anton-jh/Side-panels/Side panel left.dxf

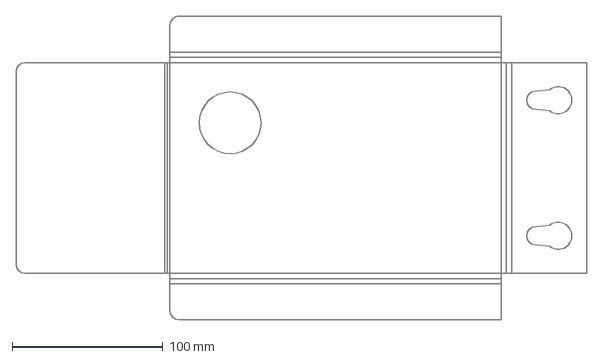
[picture p1: CAD file, 2025-12-23]
Side panel left.dxf
378.9 x 201.6 mm
