anton-jh/Side-panels/Adapter bracket primary.dxf

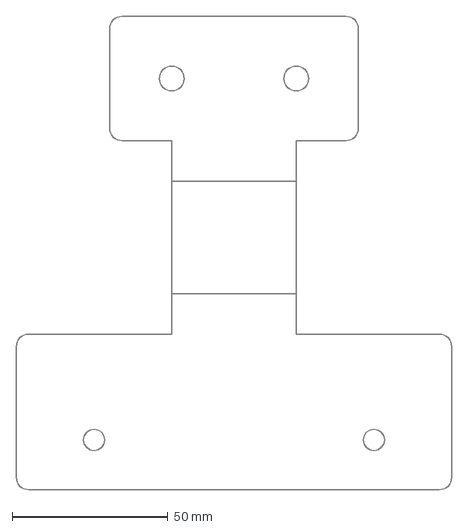
[picture p2: CAD file, 2025-12-23]
Adapter bracket primary.dxf
140.0 x 152.2 mm
