anton-jh/Side-panels/Chair mount adapter.dxf

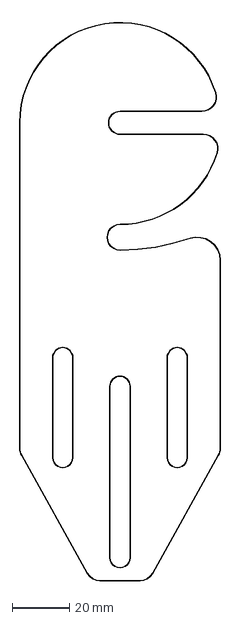
[picture p3: CAD file, 2025-12-23]
Chair mount adapter.dxf
70.0 x 197.2 mm
