anton-jh/Side-panels/Adapter bracket secondary left.dxf

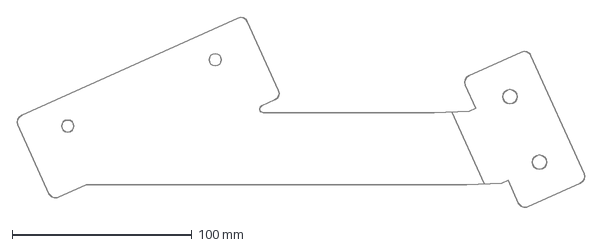
[picture p4: CAD file, 2025-12-23]
Adapter bracket secondary left.dxf
316.8 x 106.4 mm
