anton-jh/Side-panels/PCBs/Shift_Register_Module/Shift_Register_Module.kicad_pcb

## KiCad design PCBs/Shift_Register_Module/Shift_Register_Module.kicad_pcb (2026-11-09)

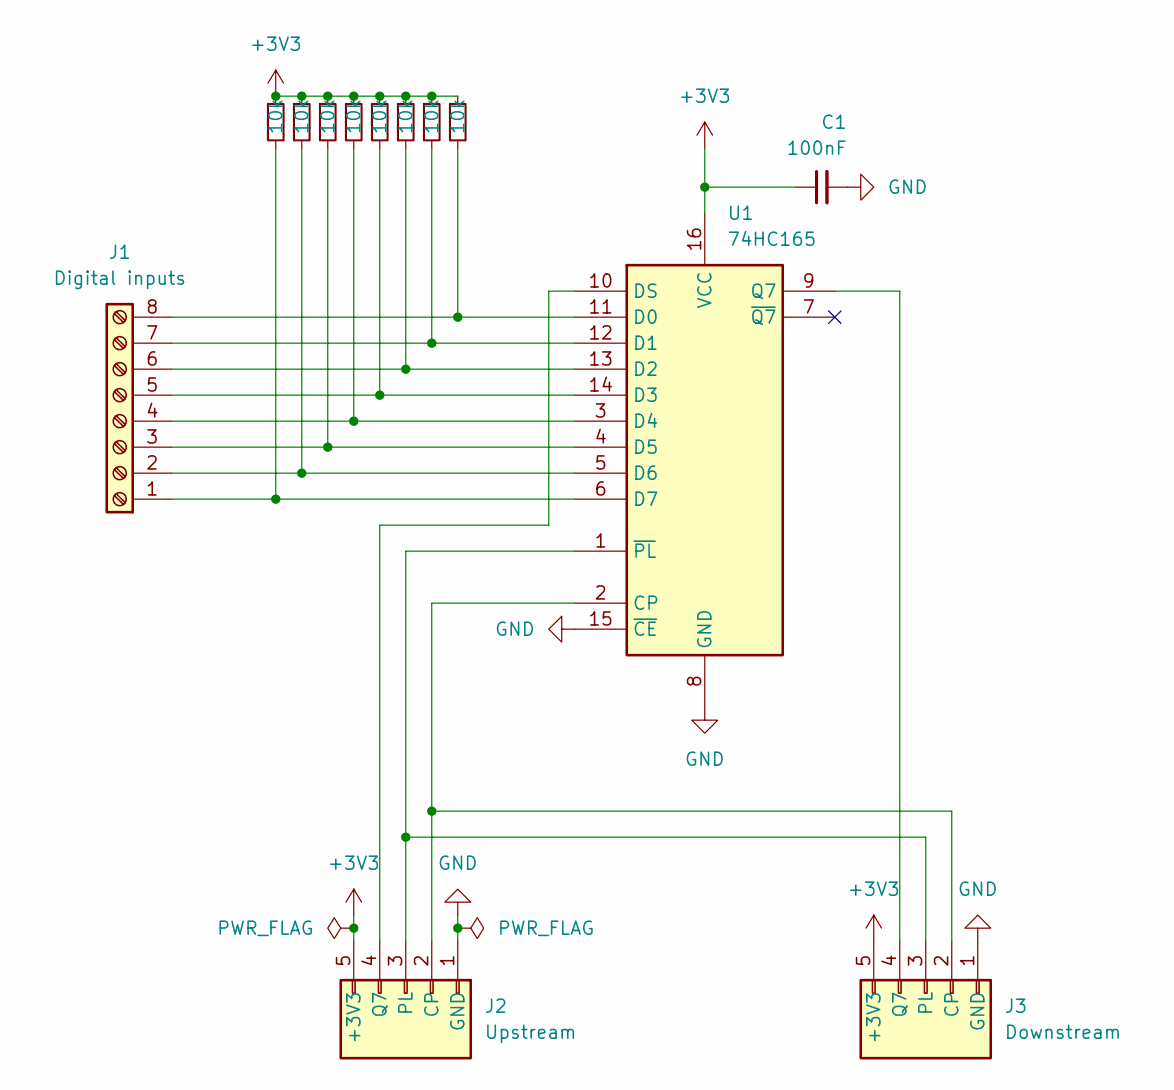
[picture p5: schematic Shift_Register_Module.kicad_sch]

Parts:
C1: 100nF; C_Disc_D5.0mm_W2.5mm_P2.50mm
J1: Digital inputs; TerminalBlock_Phoenix_MPT-0,5-8-2.54_1x08_P2.54mm_Horizontal
J2: Upstream; PinSocket_1x05_P2.54mm_Horizontal
J3: Downstream; PinHeader_1x05_P2.54mm_Horizontal
R1, R2, R3, R4, R5, R6, R7, R8: 10k; R_Axial_DIN0204_L3.6mm_D1.6mm_P1.90mm_Vertical
U1: 74HC165; DIP-16_W7.62mm_Socket

Connections:
+3V3: C1.1, J2.5 (+3V3), J3.5 (+3V3), R1.1, R2.1, R3.1, R4.1, R5.1, R6.1, R7.1, R8.1, U1.16 (VCC)
GND: C1.2, J2.1 (GND), J3.1 (GND), U1.8 (GND), U1.15 (~CE)
unnamed: J1.1, R1.2, U1.6 (D7)
unnamed: J1.2, R2.2, U1.5 (D6)
unnamed: J1.3, R3.2, U1.4 (D5)
unnamed: J1.4, R4.2, U1.3 (D4)
unnamed: J1.5, R5.2, U1.14 (D3)
unnamed: J1.6, R6.2, U1.13 (D2)
unnamed: J1.7, R7.2, U1.12 (D1)
unnamed: J1.8, R8.2, U1.11 (D0)
unnamed: J2.2 (CP), J3.2 (CP), U1.2 (CP)
unnamed: J2.4 (SER), U1.10 (DS)
unnamed: J2.3 (/PL), J3.3 (/PL), U1.1 (~PL)
unnamed: J3.4 (SER), U1.9 (Q7)

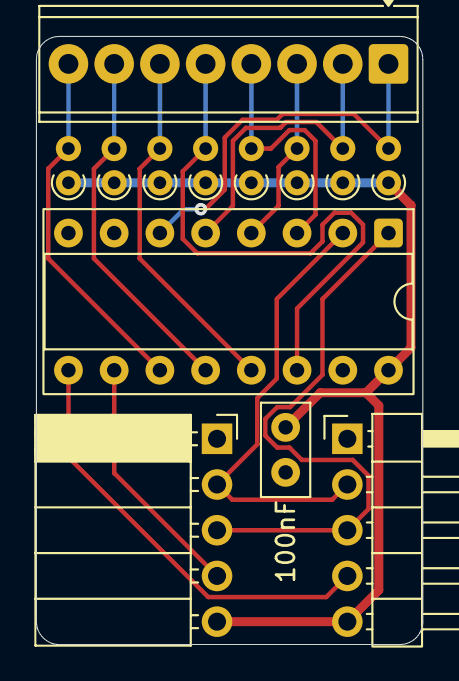
[picture p6: board Shift_Register_Module.kicad_pcb from above]

Board: 2 copper layers, 21.5 x 33.8 mm, 13 parts (0 on the bottom side), 14 nets.
