anton-jh/Side-panels/PCBs/Shared_Main/Shared_Main.kicad_pcb

## KiCad design PCBs/Shared_Main/Shared_Main.kicad_pcb (2026-11-09)

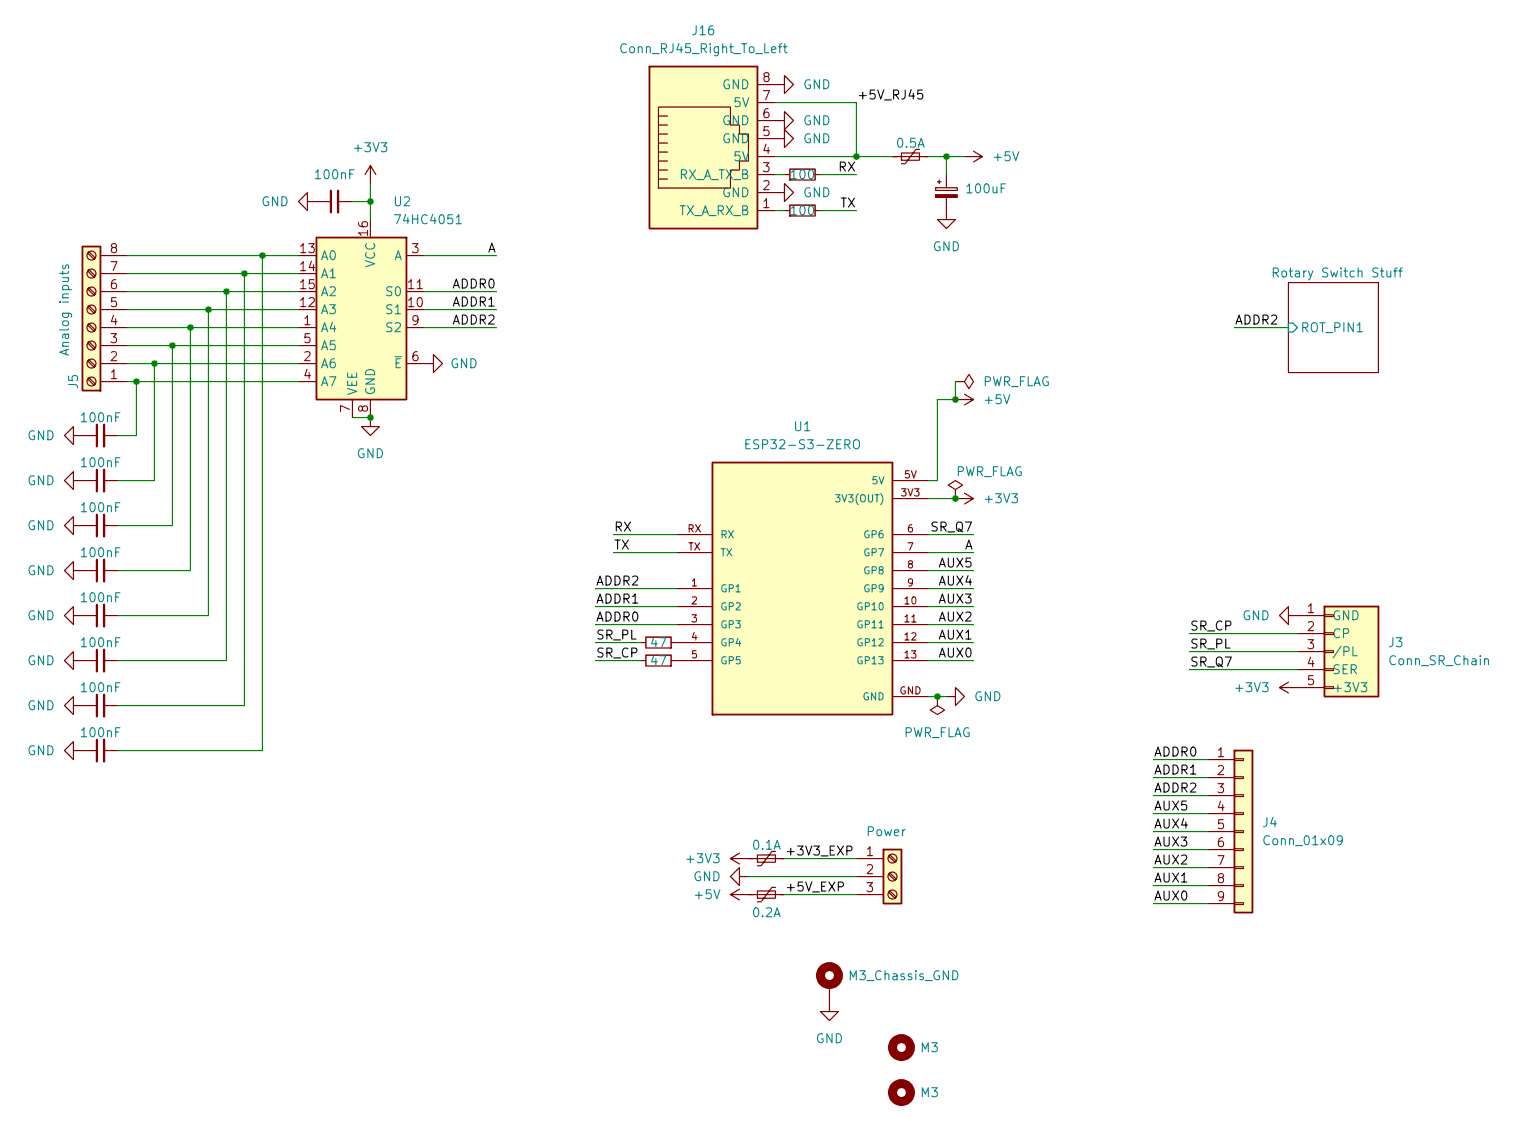
[picture p7: schematic Shared_Main.kicad_sch]

Parts:
C1, C12, C13, C14, C15, C16, C17, C18, C19: 100nF; C_Disc_D5.0mm_W2.5mm_P2.50mm
C3: 100uF; CP_Radial_D5.0mm_P2.00mm
F1: 0.5A; Fuse_Bourns_MF-RHT050
F2: 0.1A; Fuse_Bourns_MF-RHT050
F3: 0.2A; Fuse_Bourns_MF-RHT050
H1: M3_Chassis_GND; MountingHole_3.2mm_M3_DIN965_Pad_TopOnly
H2, H3: M3; MountingHole_3.2mm_M3
J1: Power; TerminalBlock_Phoenix_MKDS-1,5-3_1x03_P5.00mm_Horizontal
J3: Conn_SR_Chain; PinSocket_1x05_P2.54mm_Horizontal
J4: Conn_01x09; PinHeader_1x09_P2.54mm_Vertical
J5: Analog inputs; TerminalBlock_Phoenix_MPT-0,5-8-2.54_1x08_P2.54mm_Horizontal
J16: Conn_RJ45_Right_To_Left; RJ45_Amphenol_54602-x08_Horizontal
R2, R3: 100; R_Axial_DIN0207_L6.3mm_D2.5mm_P7.62mm_Horizontal
R9, R10: 47; R_Axial_DIN0207_L6.3mm_D2.5mm_P7.62mm_Horizontal
U1: ESP32-S3-ZERO; MODULE_ESP32-S3-ZERO; PARTREV NA
U2: 74HC4051; DIP-16_W7.62mm_Socket

Connections:
+3V3: C1.2, F2.1, J3.5 (+3V3), U1.3V3 (3V3(OUT)), U2.16 (VCC)
+5V: C3.1, F1.2, F3.1, U1.5V
/+3V3_EXP: F2.2, J1.1
/+5V_EXP: F3.2, J1.3
/+5V_RJ45: F1.1, J16.4 (5V), J16.7 (5V)
/A: U1.7 (GP7), U2.3 (A)
/ADDR0: J4.1, U1.3 (GP3), U2.11 (S0)
/ADDR1: J4.2, U1.2 (GP2), U2.10 (S1)
/ADDR2: J4.3, U1.1 (GP1), U2.9 (S2); also elsewhere on the board
/AUX0: J4.9, U1.13 (GP13)
/AUX1: J4.8, U1.12 (GP12)
/AUX2: J4.7, U1.11 (GP11)
/AUX3: J4.6, U1.10 (GP10)
/AUX4: J4.5, U1.9 (GP9)
/AUX5: J4.4, U1.8 (GP8)
/RX: R2.2, U1.RX
/SR_CP: J3.2 (CP), R10.2
/SR_PL: J3.3 (/PL), R9.2
/SR_Q7: J3.4 (SER), U1.6 (GP6)
/TX: R3.2, U1.TX
GND: C1.1, C3.2, C12.1, C13.1, C14.1, C15.1, C16.1, C17.1, C18.1, C19.1, H1.1 (1_1), J1.2, J3.1 (GND), J16.2 (GND), J16.5 (GND), J16.6 (GND), J16.8 (GND), U1.GND, U2.6 (~E), U2.7 (VEE), U2.8 (GND); also elsewhere on the board
unnamed: C12.2, J5.1, U2.4 (A7)
unnamed: C13.2, J5.2, U2.2 (A6)
unnamed: C14.2, J5.3, U2.5 (A5)
unnamed: C15.2, J5.4, U2.1 (A4)
unnamed: C16.2, J5.5, U2.12 (A3)
unnamed: C17.2, J5.6, U2.15 (A2)
unnamed: C18.2, J5.7, U2.14 (A1)
unnamed: C19.2, J5.8, U2.13 (A0)
unnamed: J16.3 (RX_A_TX_B), R2.1
unnamed: J16.1 (TX_A_RX_B), R3.1
unnamed: R9.1, U1.4 (GP4)
unnamed: R10.1, U1.5 (GP5)

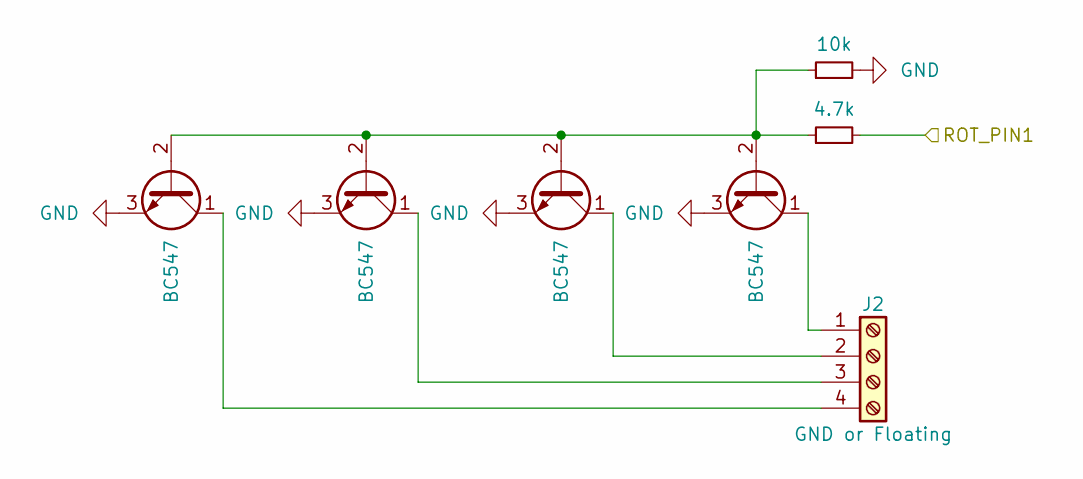
[picture p8: schematic Rotary_Switch_Stuff.kicad_sch]

Parts:
J2: GND or Floating; TerminalBlock_Phoenix_MPT-0,5-4-2.54_1x04_P2.54mm_Horizontal
Q1, Q2, Q3, Q4: BC547; TO-92_Inline_Wide
R1: 4.7k; R_Axial_DIN0207_L6.3mm_D2.5mm_P7.62mm_Horizontal
R7: 10k; R_Axial_DIN0207_L6.3mm_D2.5mm_P7.62mm_Horizontal

Connections:
/ADDR2: R1.2; also elsewhere on the board
GND: Q1.3 (E), Q2.3 (E), Q3.3 (E), Q4.3 (E), R7.2; also elsewhere on the board
unnamed: J2.1, Q4.1 (C)
unnamed: J2.2, Q3.1 (C)
unnamed: J2.3, Q2.1 (C)
unnamed: J2.4, Q1.1 (C)
unnamed: Q1.2 (B), Q2.2 (B), Q3.2 (B), Q4.2 (B), R1.1, R7.1

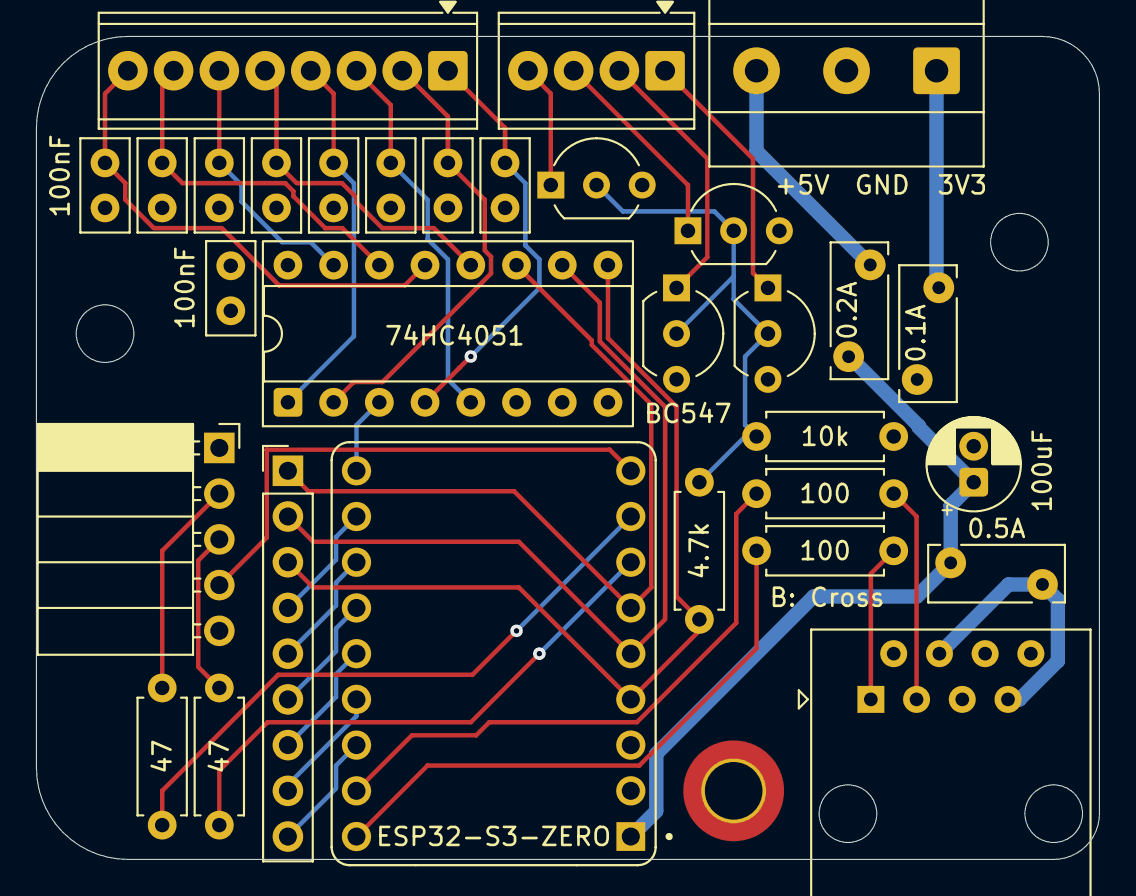
[picture p9: board Shared_Main.kicad_pcb from above]

Board: 4 copper layers, 59.1 x 45.7 mm, 34 parts (0 on the bottom side), 38 nets.
