anton-jh/Side-panels/PCBs/Right_Keypad/Right_Keypad.kicad_pcb

## KiCad design PCBs/Right_Keypad/Right_Keypad.kicad_pcb (2026-11-03)

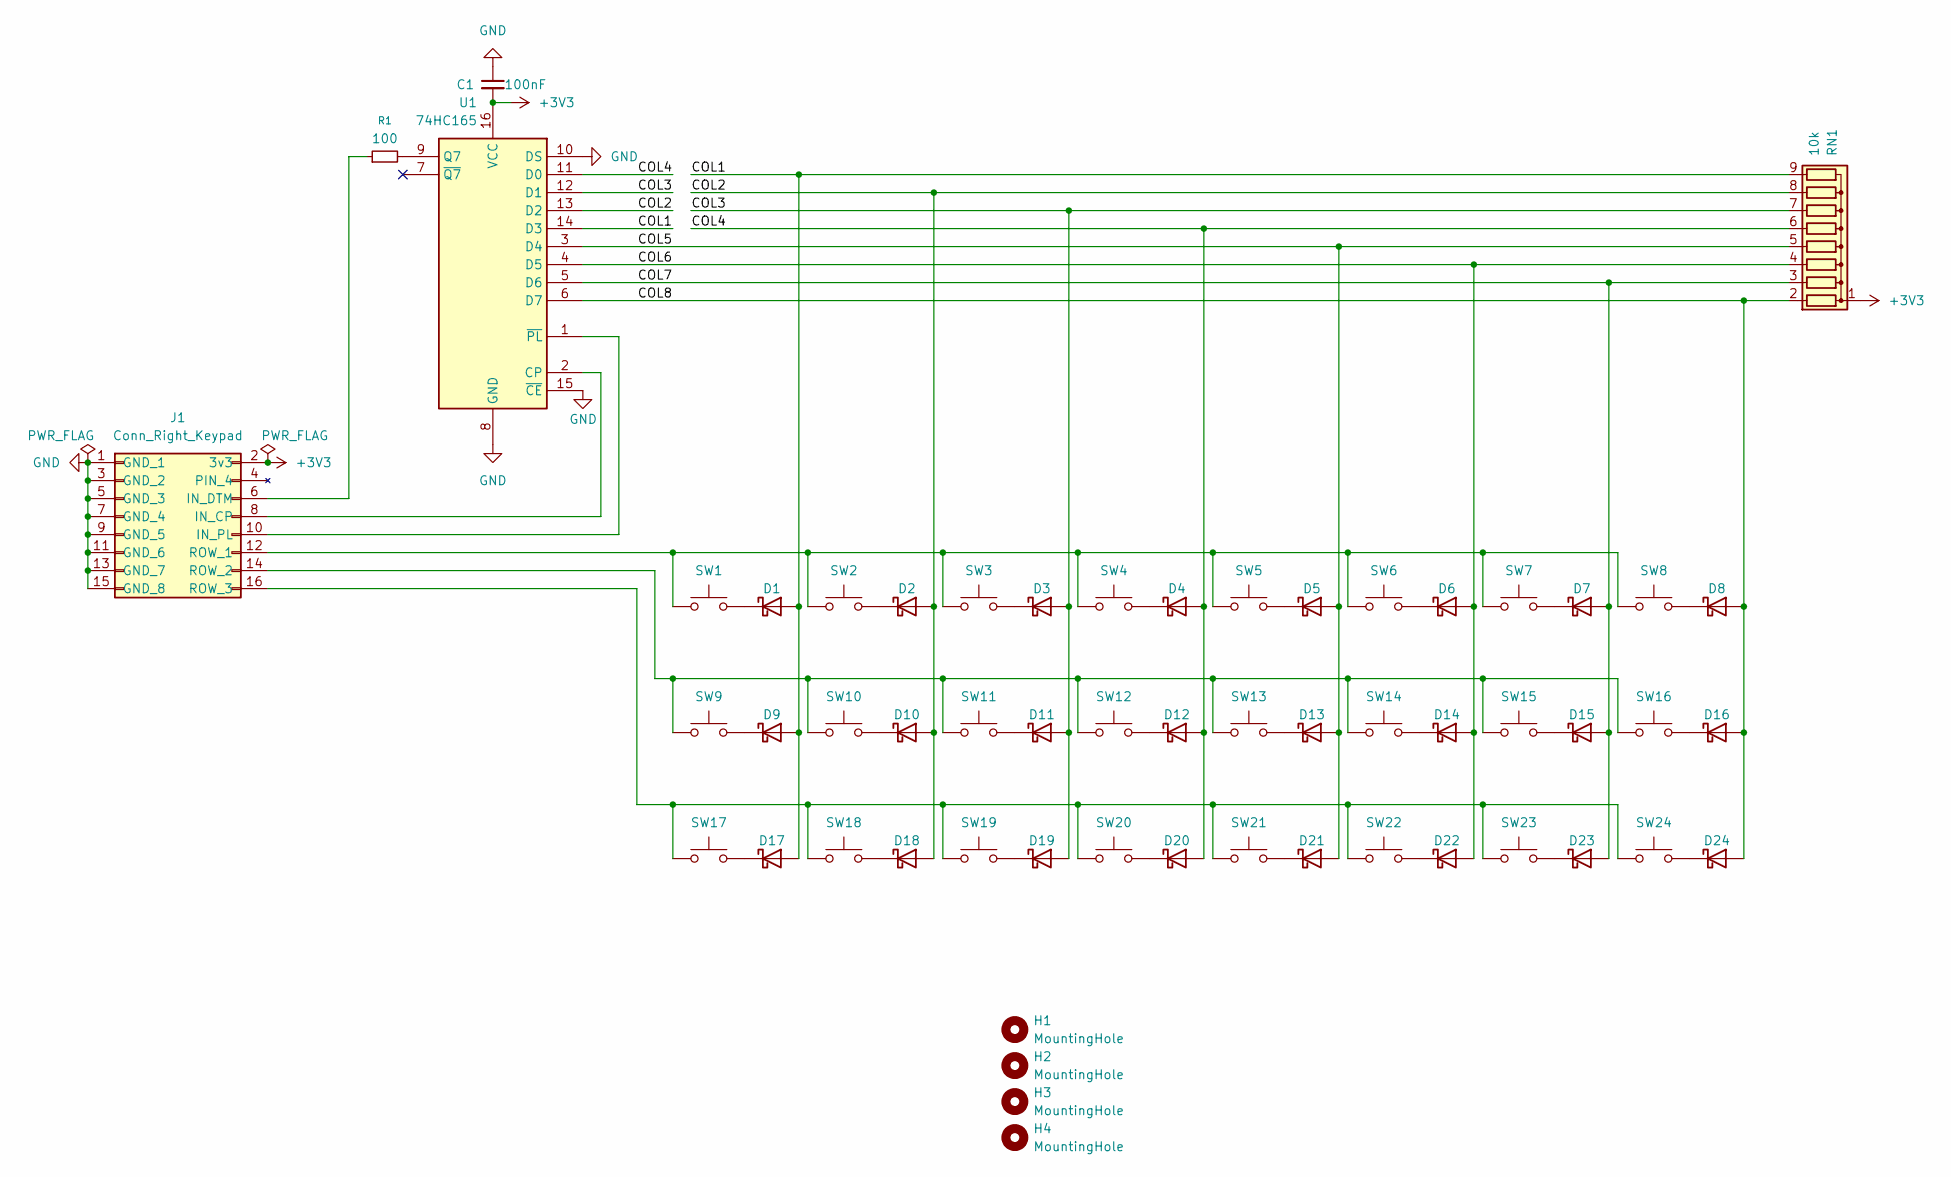
[picture p10: schematic Right_Keypad.kicad_sch]

Parts:
C1: 100nF; C_Disc_D5.0mm_W2.5mm_P2.50mm
D1, D2, D3, D4, D5, D6, D7, D8, D9, D10, D11, D12, D13, D14, D15, D16, D17, D18, D19, D20, D21, D22, D23, D24: SD103AWS; D_SOD-323_HandSoldering
H1, H2, H3, H4: MountingHole; MountingHole_3.2mm_M3
J1: Conn_Right_Keypad; IDC-Header_2x08_P2.54mm_Vertical
R1: 100; R_Axial_DIN0207_L6.3mm_D2.5mm_P7.62mm_Horizontal
RN1: 10k; R_Array_SIP9
SW1, SW2, SW3, SW4, SW5, SW6, SW7, SW8, SW9, SW10, SW11, SW12, SW13, SW14, SW15, SW16, SW17, SW18, SW19, SW20, SW21, SW22, SW23, SW24: SW_Push; SW_PUSH-12mm_Grid
U1: 74HC165; DIP-16_W7.62mm

Connections:
+3V3: C1.2, J1.2 (3v3), RN1.1 (common), U1.16 (VCC)
/COL1: D1.2 (A), D9.2 (A), D17.2 (A), RN1.9 (R8), U1.14 (D3)
/COL2: D2.2 (A), D10.2 (A), D18.2 (A), RN1.8 (R7), U1.13 (D2)
/COL3: D3.2 (A), D11.2 (A), D19.2 (A), RN1.7 (R6), U1.12 (D1)
/COL4: D4.2 (A), D12.2 (A), D20.2 (A), RN1.6 (R5), U1.11 (D0)
/COL5: D5.2 (A), D13.2 (A), D21.2 (A), RN1.5 (R4), U1.3 (D4)
/COL6: D6.2 (A), D14.2 (A), D22.2 (A), RN1.4 (R3), U1.4 (D5)
/COL7: D7.2 (A), D15.2 (A), D23.2 (A), RN1.3 (R2), U1.5 (D6)
/COL8: D8.2 (A), D16.2 (A), D24.2 (A), RN1.2 (R1), U1.6 (D7)
GND: C1.1, J1.1 (GND_1), J1.3 (GND_2), J1.5 (GND_3), J1.7 (GND_4), J1.9 (GND_5), J1.11 (GND_6), J1.13 (GND_7), J1.15 (GND_8), U1.8 (GND), U1.10 (DS), U1.15 (~CE)
unnamed: D1.1 (K), SW1.2
unnamed: D2.1 (K), SW2.2
unnamed: D3.1 (K), SW3.2
unnamed: D4.1 (K), SW4.2
unnamed: D5.1 (K), SW5.2
unnamed: D6.1 (K), SW6.2
unnamed: D7.1 (K), SW7.2
unnamed: D8.1 (K), SW8.2
unnamed: D9.1 (K), SW9.2
unnamed: D10.1 (K), SW10.2
unnamed: D11.1 (K), SW11.2
unnamed: D12.1 (K), SW12.2
unnamed: D13.1 (K), SW13.2
unnamed: D14.1 (K), SW14.2
unnamed: D15.1 (K), SW15.2
unnamed: D16.1 (K), SW16.2
unnamed: D17.1 (K), SW17.2
unnamed: D18.1 (K), SW18.2
unnamed: D19.1 (K), SW19.2
unnamed: D20.1 (K), SW20.2
unnamed: D21.1 (K), SW21.2
unnamed: D22.1 (K), SW22.2
unnamed: D23.1 (K), SW23.2
unnamed: D24.1 (K), SW24.2
unnamed: J1.8 (IN_CP), U1.2 (CP)
unnamed: J1.6 (IN_DTM), R1.1
unnamed: J1.10 (IN_PL), U1.1 (~PL)
unnamed: J1.12 (ROW_1), SW1.1, SW2.1, SW3.1, SW4.1, SW5.1, SW6.1, SW7.1, SW8.1
unnamed: J1.14 (ROW_2), SW9.1, SW10.1, SW11.1, SW12.1, SW13.1, SW14.1, SW15.1, SW16.1
unnamed: J1.16 (ROW_3), SW17.1, SW18.1, SW19.1, SW20.1, SW21.1, SW22.1, SW23.1, SW24.1
unnamed: R1.2, U1.9 (Q7)

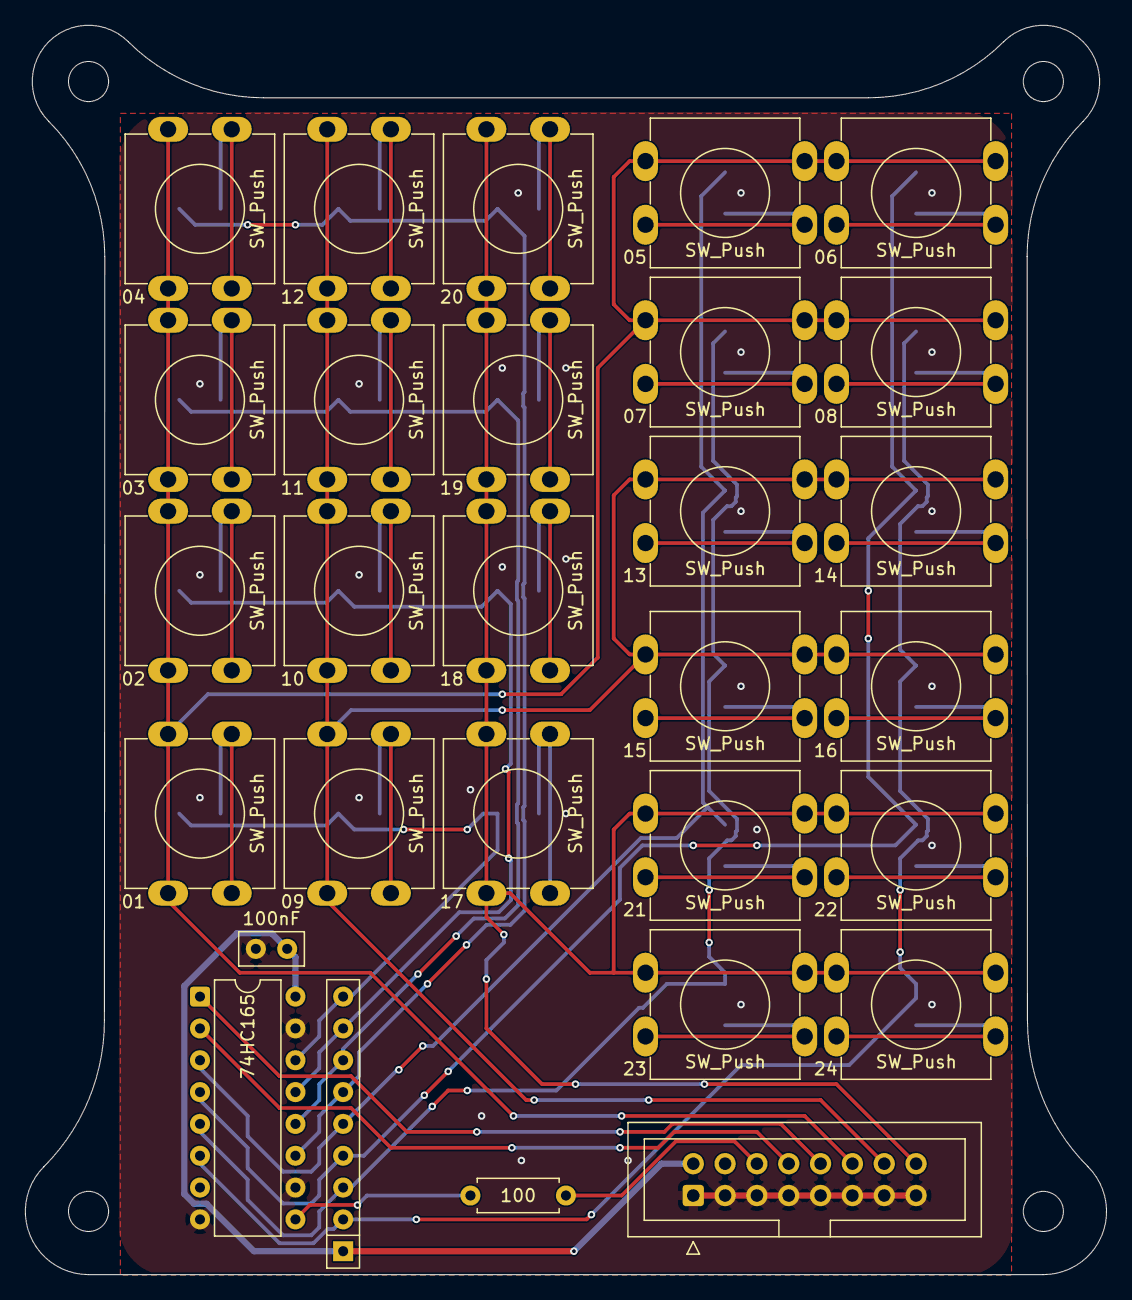
[picture p11: board Right_Keypad.kicad_pcb from above]

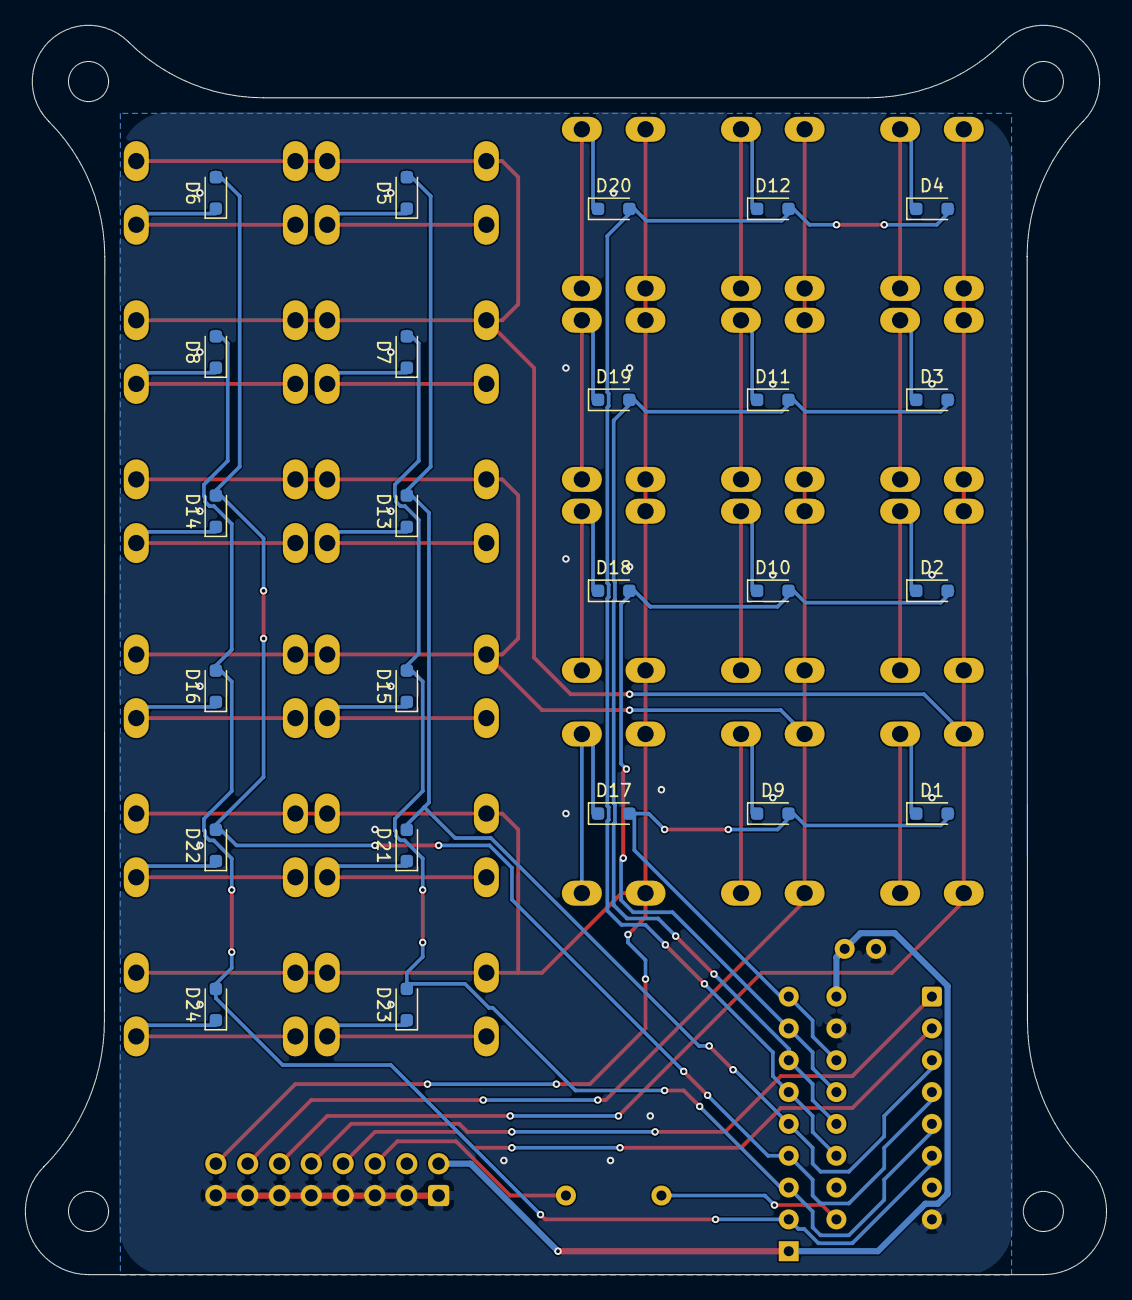
[picture p12: board Right_Keypad.kicad_pcb from below]

Board: 2 copper layers, 86.3 x 99.7 mm, 57 parts (24 on the bottom side), 41 nets.
