anton-jh/Side-panels/PCBs/Right_Main/Right_Main.kicad_pcb

## KiCad design PCBs/Right_Main/Right_Main.kicad_pcb (2026-07-09)

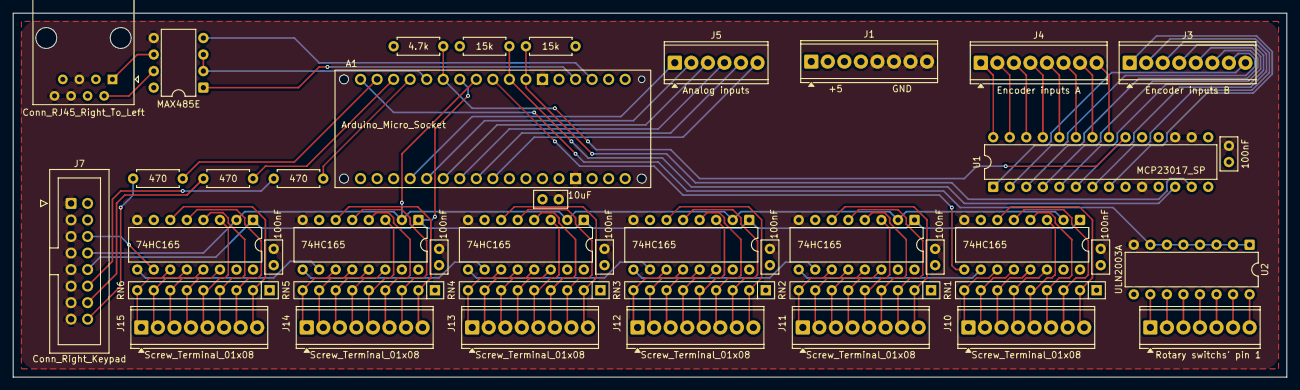
[picture p13: board Right_Main.kicad_pcb from above]

Board: 4 copper layers, 195.6 x 55.9 mm, 43 parts (0 on the bottom side), 103 nets.

Parts:
A1: Arduino_Micro_Socket
C1, C4, C5, C6, C7, C8, C9: 100nF; C_Disc_D5.0mm_W2.5mm_P2.50mm
C2: 10uF; C_Disc_D5.0mm_W2.5mm_P2.50mm
J1: +5V and GND; TerminalBlock_Phoenix_MPT-0,5-8-2.54_1x08_P2.54mm_Horizontal
J3: Encoder inputs B; TerminalBlock_Phoenix_MPT-0,5-8-2.54_1x08_P2.54mm_Horizontal
J4: Encoder inputs A; TerminalBlock_Phoenix_MPT-0,5-8-2.54_1x08_P2.54mm_Horizontal
J5: Analog inputs; TerminalBlock_Phoenix_MPT-0,5-6-2.54_1x06_P2.54mm_Horizontal
J7: Conn_Right_Keypad; IDC-Header_2x08_P2.54mm_Vertical
J8: Rotary switchs' pin 1; TerminalBlock_Phoenix_MPT-0,5-7-2.54_1x07_P2.54mm_Horizontal
J10, J11, J12, J13, J14, J15: Screw_Terminal_01x08; TerminalBlock_Phoenix_MPT-0,5-8-2.54_1x08_P2.54mm_Horizontal
J16: Conn_RJ45_Right_To_Left; RJ45_Amphenol_54602-x08_Horizontal
R1, R2: 15k; R_Axial_DIN0207_L6.3mm_D2.5mm_P7.62mm_Horizontal
R3: 4.7k; R_Axial_DIN0207_L6.3mm_D2.5mm_P7.62mm_Horizontal
R4, R5, R6: 470; R_Axial_DIN0207_L6.3mm_D2.5mm_P7.62mm_Horizontal
RN1, RN2, RN3, RN4, RN5, RN6: R_Network08; R_Array_SIP9
U1: MCP23017_SP; DIP-28_W7.62mm
U2: ULN2003A; DIP-16_W7.62mm
U4, U5, U6, U7, U8, U9: 74HC165; DIP-16_W7.62mm
U10: MAX485E; DIP-8_W7.62mm

Connections:
+5V: A1.5V, C1.1, C2.2, C4.2, C5.2, C6.2, C7.2, C8.2, C9.2, J1.1, J1.2, J1.3, J1.4, J7.2 (5V), J16.3 (+), J16.4 (+), J16.7 (+), R1.2, R2.2, R3.1, RN1.1 (common), RN2.1 (common), RN3.1 (common), RN4.1 (common), RN5.1 (common), RN6.1 (common), U1.9 (VDD), U1.15 (A0), U1.18 (~RESET), U4.16 (VCC), U5.16 (VCC), U6.16 (VCC), U7.16 (VCC), U8.16 (VCC), U9.16 (VCC), U10.8 (VCC)
/Input register 1/CP: A1.D5, J7.8 (IN_CP), U4.2 (CP), U5.2 (CP), U6.2 (CP), U7.2 (CP), U8.2 (CP), U9.2 (CP)
/Input register 1/DS: U4.10 (DS), U5.9 (Q7)
/Input register 1/Q7: A1.D4, U4.9 (Q7)
/Input register 1//PL: A1.D6, J7.10 (IN_PL), U4.1 (~PL), U5.1 (~PL), U6.1 (~PL), U7.1 (~PL), U8.1 (~PL), U9.1 (~PL)
/Input register 2/DS: U5.10 (DS), U6.9 (Q7)
/Input register 3/DS: U6.10 (DS), U7.9 (Q7)
/Input register 4/DS: U7.10 (DS), U8.9 (Q7)
/Input register 5/DS: U8.10 (DS), U9.9 (Q7)
/Input register 6/DS: J7.6 (IN_DTM), U9.10 (DS)
GND: A1.GND1 (GND), A1.GND2 (GND), C1.2, C2.1, C4.1, C5.1, C6.1, C7.1, C8.1, C9.1, J1.5, J1.6, J1.7, J1.8, J7.1 (GND_1), J7.3 (GND_2), J7.5 (GND_3), J7.7 (GND_4), J7.9 (GND_5), J7.11 (GND_6), J7.13 (GND_7), J7.15 (GND_8), J16.5 (-), J16.6 (-), J16.8 (-), U1.10 (VSS), U1.16 (A1), U1.17 (A2), U2.8 (GND), U4.8 (GND), U4.15 (~CE), U5.8 (GND), U5.15 (~CE), U6.8 (GND), U6.15 (~CE), U7.8 (GND), U7.15 (~CE), U8.8 (GND), U8.15 (~CE), U9.8 (GND), U9.15 (~CE), U10.5 (GND)
unnamed: A1.D0 (D0/RX), U10.1 (RO)
unnamed: A1.D1 (D1/TX), U10.4 (DI)
unnamed: A1.D2 (D2/SDA), R2.1, U1.13 (SDA)
unnamed: A1.D3 (D3/SCL), R1.1, U1.12 (SCK)
unnamed: A1.D7 (D7_INT4), R3.2, U1.20 (INTA)
unnamed: A1.D9, R4.1
unnamed: A1.D10, R5.1
unnamed: A1.D11, R6.1
unnamed: J3.8, U1.1 (GPB0)
unnamed: J3.7, U1.2 (GPB1)
unnamed: J3.6, U1.3 (GPB2)
unnamed: J3.5, U1.4 (GPB3)
unnamed: J3.4, U1.5 (GPB4)
unnamed: J3.3, U1.6 (GPB5)
unnamed: J3.2, U1.7 (GPB6)
unnamed: J3.1, U1.8 (GPB7)
unnamed: J4.1, U1.28 (GPA7)
unnamed: J4.2, U1.27 (GPA6)
unnamed: J4.3, U1.26 (GPA5)
unnamed: J4.4, U1.25 (GPA4)
unnamed: J4.5, U1.24 (GPA3)
unnamed: J4.6, U1.23 (GPA2)
unnamed: J4.7, U1.22 (GPA1)
unnamed: J4.8, U1.21 (GPA0)
unnamed: A1.A0, J5.1
unnamed: A1.A1, J5.2
unnamed: A1.A2, J5.3
unnamed: A1.A3, J5.4
unnamed: A1.A4, J5.5
unnamed: A1.A5, J5.6
unnamed: J7.12 (ROW_1), R4.2
unnamed: J7.14 (ROW_2), R5.2
unnamed: J7.16 (ROW_3), R6.2
unnamed: J8.1, U2.10 (O7)
unnamed: J8.2, U2.11 (O6)
unnamed: J8.3, U2.12 (O5)
unnamed: J8.4, U2.13 (O4)
unnamed: J8.5, U2.14 (O3)
unnamed: J8.6, U2.15 (O2)
unnamed: J8.7, U2.16 (O1)
unnamed: J10.1, RN1.9 (R8), U4.11 (D0)
unnamed: J10.2, RN1.8 (R7), U4.12 (D1)
unnamed: J10.3, RN1.7 (R6), U4.13 (D2)
unnamed: J10.4, RN1.6 (R5), U4.14 (D3)
unnamed: J10.5, RN1.5 (R4), U4.3 (D4)
unnamed: J10.6, RN1.4 (R3), U4.4 (D5)
unnamed: J10.7, RN1.3 (R2), U4.5 (D6)
unnamed: J10.8, RN1.2 (R1), U4.6 (D7)
unnamed: J11.1, RN2.9 (R8), U5.11 (D0)
unnamed: J11.2, RN2.8 (R7), U5.12 (D1)
unnamed: J11.3, RN2.7 (R6), U5.13 (D2)
unnamed: J11.4, RN2.6 (R5), U5.14 (D3)
unnamed: J11.5, RN2.5 (R4), U5.3 (D4)
unnamed: J11.6, RN2.4 (R3), U5.4 (D5)
unnamed: J11.7, RN2.3 (R2), U5.5 (D6)
unnamed: J11.8, RN2.2 (R1), U5.6 (D7)
unnamed: J12.1, RN3.9 (R8), U6.11 (D0)
unnamed: J12.2, RN3.8 (R7), U6.12 (D1)
unnamed: J12.3, RN3.7 (R6), U6.13 (D2)
unnamed: J12.4, RN3.6 (R5), U6.14 (D3)
unnamed: J12.5, RN3.5 (R4), U6.3 (D4)
unnamed: J12.6, RN3.4 (R3), U6.4 (D5)
unnamed: J12.7, RN3.3 (R2), U6.5 (D6)
unnamed: J12.8, RN3.2 (R1), U6.6 (D7)
unnamed: J13.1, RN4.9 (R8), U7.11 (D0)
unnamed: J13.2, RN4.8 (R7), U7.12 (D1)
unnamed: J13.3, RN4.7 (R6), U7.13 (D2)
unnamed: J13.4, RN4.6 (R5), U7.14 (D3)
unnamed: J13.5, RN4.5 (R4), U7.3 (D4)
unnamed: J13.6, RN4.4 (R3), U7.4 (D5)
unnamed: J13.7, RN4.3 (R2), U7.5 (D6)
unnamed: J13.8, RN4.2 (R1), U7.6 (D7)
unnamed: J14.1, RN5.9 (R8), U8.11 (D0)
unnamed: J14.2, RN5.8 (R7), U8.12 (D1)
unnamed: J14.3, RN5.7 (R6), U8.13 (D2)
unnamed: J14.4, RN5.6 (R5), U8.14 (D3)
unnamed: J14.5, RN5.5 (R4), U8.3 (D4)
unnamed: J14.6, RN5.4 (R3), U8.4 (D5)
unnamed: J14.7, RN5.3 (R2), U8.5 (D6)
unnamed: J14.8, RN5.2 (R1), U8.6 (D7)
unnamed: J15.1, RN6.9 (R8), U9.11 (D0)
unnamed: J15.2, RN6.8 (R7), U9.12 (D1)
unnamed: J15.3, RN6.7 (R6), U9.13 (D2)
unnamed: J15.4, RN6.6 (R5), U9.14 (D3)
unnamed: J15.5, RN6.5 (R4), U9.3 (D4)
unnamed: J15.6, RN6.4 (R3), U9.4 (D5)
unnamed: J15.7, RN6.3 (R2), U9.5 (D6)
unnamed: J15.8, RN6.2 (R1), U9.6 (D7)
unnamed: J16.1 (485_A), U10.6 (A)
unnamed: J16.2 (485_B), U10.7 (B)
unnamed: A1.D12, U2.1 (I1), U2.2 (I2), U2.3 (I3), U2.4 (I4), U2.5 (I5), U2.6 (I6), U2.7 (I7)
unnamed: A1.D8, U10.2 (~RE), U10.3 (DE)
