anton-jh/Side-panels/(commit log)

2025-12-23 Initial commit to combined repo
    [Adapter bracket primary.dxf, Adapter bracket secondary left.dxf, Chair mount adapter.dxf, Input_Shift_Register.kicad_sch, Left_Main.kicad_pcb, Left_Main.kicad_sch, Right_Main.kicad_pcb, Right_Main.kicad_sch]
2026-01-01 before moving keypad shift regs
    [Right_Keypad.kicad_pcb, Right_Keypad.kicad_sch]
2026-01-03 Moved shift registers
    [Right_Keypad.kicad_pcb, Right_Keypad.kicad_sch]
2026-04-15 before UART+RS485
    [Right_Keypad.kicad_pcb, Right_Keypad.kicad_sch]
2026-06-27 UART+RS485 + KiCad 10 + keypad PCB v1
    [Input_Shift_Register.kicad_sch, Right_Keypad.kicad_pcb, Right_Keypad.kicad_sch, Right_Main.kicad_sch]
2026-06-30 ESD protection and stuff
    [Right_Keypad.kicad_pcb, Right_Keypad.kicad_sch]
2026-06-30 finishing touches and silkscreen stuff
    [Right_Keypad.kicad_pcb, Right_Keypad.kicad_sch]
2026-07-01 right keypad ready
    [Right_Keypad.kicad_pcb]
2026-07-05 right main pcb draft
    [Input_Shift_Register.kicad_sch, Right_Keypad.kicad_pcb, Right_Keypad.kicad_sch, Right_Main.kicad_pcb, Right_Main.kicad_sch]
2026-07-05 right main pcb draft 2 wip
    [Right_Main.kicad_pcb]
2026-07-12 Renamed Right_Main to Shared_Main. Removed Left and System
    [Input_Shift_Register.kicad_sch, Left_Main.kicad_pcb, Left_Main.kicad_sch, Shared_Main.kicad_pcb, Shared_Main.kicad_sch, System.kicad_sch]
2026-07-12 Shared main with ESP32-S3-ZERO's, schematic draft
    [Rotary_Switch_Stuff.kicad_sch, Shared_Main.kicad_sch]
2026-07-14 shared main wip
    [Input_Shift_Register.kicad_sch, Rotary_Switch_Stuff.kicad_sch, Shared_Main.kicad_pcb, Shared_Main.kicad_sch]
2026-07-14 keypad 3v3, before removing transistors
    [Right_Keypad.kicad_sch]
2026-08-22 Fix 74HC4051 enable, set pull-up values, name keypad column nets
    Shared_Main:
    - U2 (74HC4051) pin 6 (~E) was tied to +3V3, permanently inhibiting all
    eight analog channels. Moved to GND. The pad had no tracks on it, so
    the board change is just which plane claims it (In2 +3V3 -> In1 GND);
    all zones refilled.
    - RN1-RN6 pull-up arrays had no value assigned (still reading the
    R_Network08 symbol default). Set to 10k, matching RN8. Board footprint
    value fields synced to match.
    - Also includes graphical tidy-up of junction/wire placement (no netlist
    change).
    Right_Keypad:
    - RN1 pull-up array set to 10k, board field synced.
    - U1 was using a locally modified 74HC165 whose D0-D3 pins had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
2026-10-22 change to vertical spring terminals
2026-10-23 reduce to 4 rotary switch pin-1s
2026-10-24 reorganizing main pcb
2026-10-25 aisler design rules for both pcbs
    Both boards go to AISLER: Right_Keypad as 2 layer 1.6mm 35um ENIG,
    Shared_Main as 4 layer 1.6mm 35um ENIG. There is no HASL option on four
    layers at all, and the keypad's 0.6/0.3 vias leave a 0.15mm annular ring
    against HASL's 0.175mm minimum, so ENIG for both.
    PCBs/design-rules/Apply-AislerRules.ps1 is the single source of truth. It
    generates each project's .kicad_dru and edits the Board Setup constraints
    and DRC severities in the .kicad_pro in place, so the numbers no longer
    have to be typed into the GUI. Run it with -Check to verify without
    writing anything.
    The limits are split across the two files on purpose. Board Setup
    constraints are absolute floor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
2026-10-25 silkscreen labels and tweaks
2026-10-26 revert to horizontal screw terminals to save cost
2026-11-02 completely new shared board, draft
2026-11-03 update CLAUDE.md with 4 transistors, 8 165s and note about GND
2026-11-03 remove chassis ring on keypad and make it smaller + chassis gnd on main pcb by mcu
2026-11-04 re-use addr2 for rotary switches = one more spare pin
2026-11-04 Add firmware plan for boards A and B
    Outline of the shared scanner/input-processing code, the B->A link
    protocol, and board A's mapping, pulse engine, master-mode and zero
    switch handling, USB HID layout, debug tooling, milestones and open
    questions. Pin/bit maps are derived from the current Shared_Main and
    Right_Keypad netlists.
    Claude-Session: https://claude.ai/code/session_015QDee16joGBZEkH2ocqNLw
2026-11-04 Firmware plan: apply review feedback
    - R2/R3 crossed on board B: same UART pins on both boards, no contention
    - Rotary switches are make-before-break: ~200 ms central stable time
    - Selectors: A derives up/down from position change; only encoders send counters
    - Mode switch: position only, end stop
    - Central 100 ms minimum pulse on/off time
    - HID: one joystick per unit (JA/JB) + keyboard
    - Zero switch: axes to 0, only on-off/on-off-on toggles replay pulses
    - Generic modes with output-type filters and a fixed button layout
    - Record decisions, trim open questions
    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
2026-11-04 Firmware plan: filter switches, 3-position zero switch, per-mode axis neutrals
    - Master mode only selects the mapping; on-off filter switches decide which
    output classes (positions, up/down pulses, ...) are reported in every mode
    - Output classes propagate through Signal values so filtering needs no
    per-mode code; one generic mode with a fixed layout
    - Zero switch becomes on-off-on: zero + re-report, and zero + capture
    (one pulse of the last logical button activated and deactivated)
    - Neutral axis values per axis and master mode
    - Reset only state that cannot be inferred from physical switches
    Claude-Session: https://claude.ai/co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
2026-11-04 Firmware plan: isolated binding mode pulses each completed press-release
    Zero switch side 2 now emits one pulse per logical button/key right after
    it is pressed and released while in the mode, instead of a single pulse of
    the last one on return. Record decisions on capture scope and encoder
    filtering; explain the fixed generic button numbering.
    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
2026-11-04 Firmware plan: standalone m:n bindings, three ways to drive axes, sub-modes
    - Make explicit that bindings are standalone (junction-table style), so one
    switch can report position and emit pulses with per-binding options
    - On-off toggles get a held button per position in the generic layout
    - Logical axes: direct, integral of a physical axis, integral of buttons;
    integrator state scoped to the master mode
    - Sub-modes are plain control flow in the mode
    - Drop queued pulses when leaving isolated binding mode
    - Flag the generic-layout button budget as an open question
    Claude-Session: https://claude.ai/code/session_015QDee16joGBZEkH2ocqN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
2026-11-04 Firmware plan: drop the generic mode, add optional second controller per unit
    All master modes are hand-written mappings that decide what is reported
    and fit it into the available buttons. Add a compile-time option for a
    second game controller per unit, explain that filters never renumber
    outputs, and record the decision that virtual axes keep integrating while
    zeroed.
    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
2026-11-04 Firmware plan: record answers on mode-switch channel, acceleration, config
    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
2026-11-04 Firmware plan: caps fitted, assume no USB diode, data-only debug cable
    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
2026-11-04 Firmware plan: follow new pin map (rotary phase on ADDR2, analog on GPIO7)
    Update the pin table, rotary phase description and scan schedule for the
    PCB change that drives the rotary-switch transistors from ADDR2 and moves
    PL/CP/Q7/analog to GPIO4-7, freeing GPIO8-13 as AUX5-AUX0. GPIO7 is
    ADC1_CH6.
    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
2026-11-04 Update CLAUDE.md to match the current hardware and firmware design
    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
2026-11-04 Shorten rotary-switch debounce to ~20 ms with a 100 ms non-adjacent rule
    Transition readings are garbage or one of the two adjacent positions, so a
    long stable time isn't needed. Keep a short one against chatter, and a
    longer one for non-adjacent jumps, because mixing phase samples across the
    6/7 and 12/1 boundaries yields valid codes for positions 12 and 7. Note the
    pulse engine's 5/s limit and add a console view for tuning.
    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
2026-11-04 Add Nano rotary-switch bench sketch; renumber rotary positions clockwise
    - firmware/bench/rotary12_nano: Arduino Nano test sketch for one 7-contact
    12-position rotary switch, using the planned scan timing (10 kHz tick,
    2.4 ms two-phase frame) and debouncer (20 ms / 100 ms non-adjacent).
    - FIRMWARE_PLAN.md §5.3: truth table now in clockwise position order with
    the pin numbering unchanged, plus a note on which pins each position
    connects. Phase-mix artefacts rechecked; still 6<->7 and 12<->1.
2026-11-04 Rotary switch: 1 s stable time for non-adjacent jumps
    Halfway between positions 12 and 1 the wiper touches pin 1 and the pin-7
    common only, which is the real code of position 6. On the bench a slow
    turn held it longer than the 50 ms jump time and registered 6.
    - Bench sketch: kRotaryJumpStableTime 1000 ms; the first reading after boot
    uses the short kRotaryStableTime; code logging enabled.
    - FIRMWARE_PLAN.md §5.3/§13 and CLAUDE.md: describe the 12<->1 contact
    state and the new jump rule.
2026-11-05 tiny shared pcb + shift reg modules, wip
2026-11-09 Add Moza R5 pot steering test (Arduino Nano + C# DirectInput app)
    The Nano reads a pot (16x oversampled) and streams it over serial. The
    PC app moves the centre of a DirectInput spring effect to match, with
    damper, speed limit, smoothing and deadband settings for tuning.
